Liu021115/WeatherStation/README.md

# WeatherStation

SDFN所在做的气象站

1.程序分为三个分支，分别为main，USB，OTA

2.每个文件夹内程序前缀：

RYK为老版本传感器，风速，风向等单独使用

XD为新版本传感器，七合一使用

3.程序后缀为开发板晶振（打板时有两种）

4.USB版本开发板上带有TYPC-C接口，移植文件系统可以从本地读取历史信息

OTA版本使用16MHz开发板，与USB版本相同，新增远程升级功能
