Liu021115/WeatherStation/执行流程图.jpg

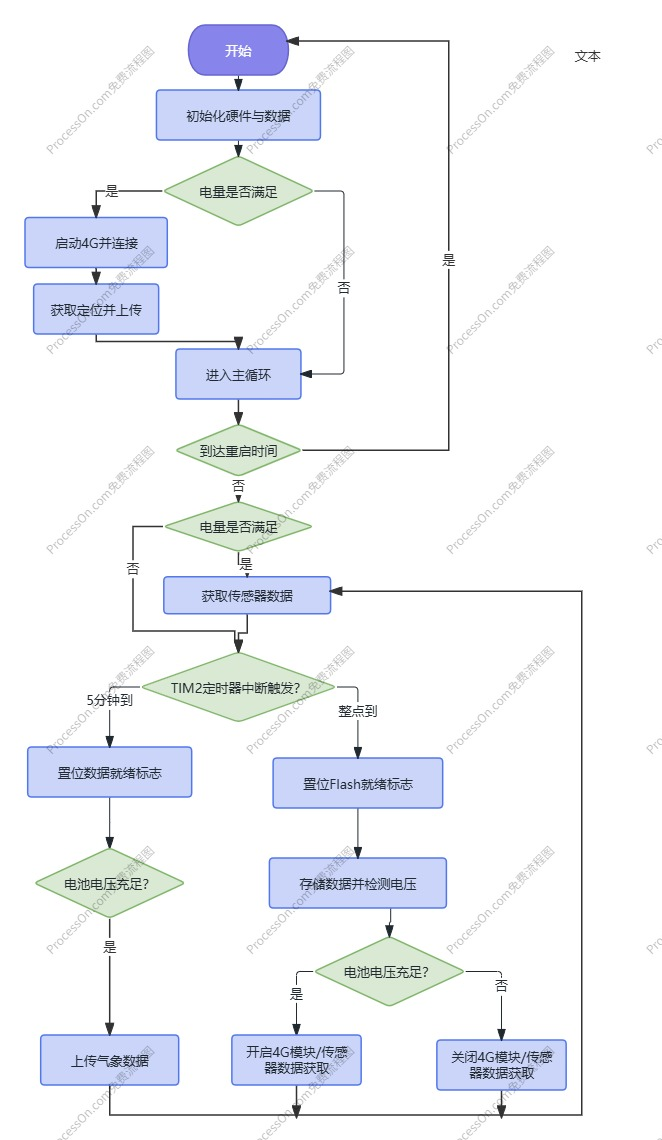
执行流程图.jpg
