Liu021115/WeatherStation/原理图.pdf

雨控
电源

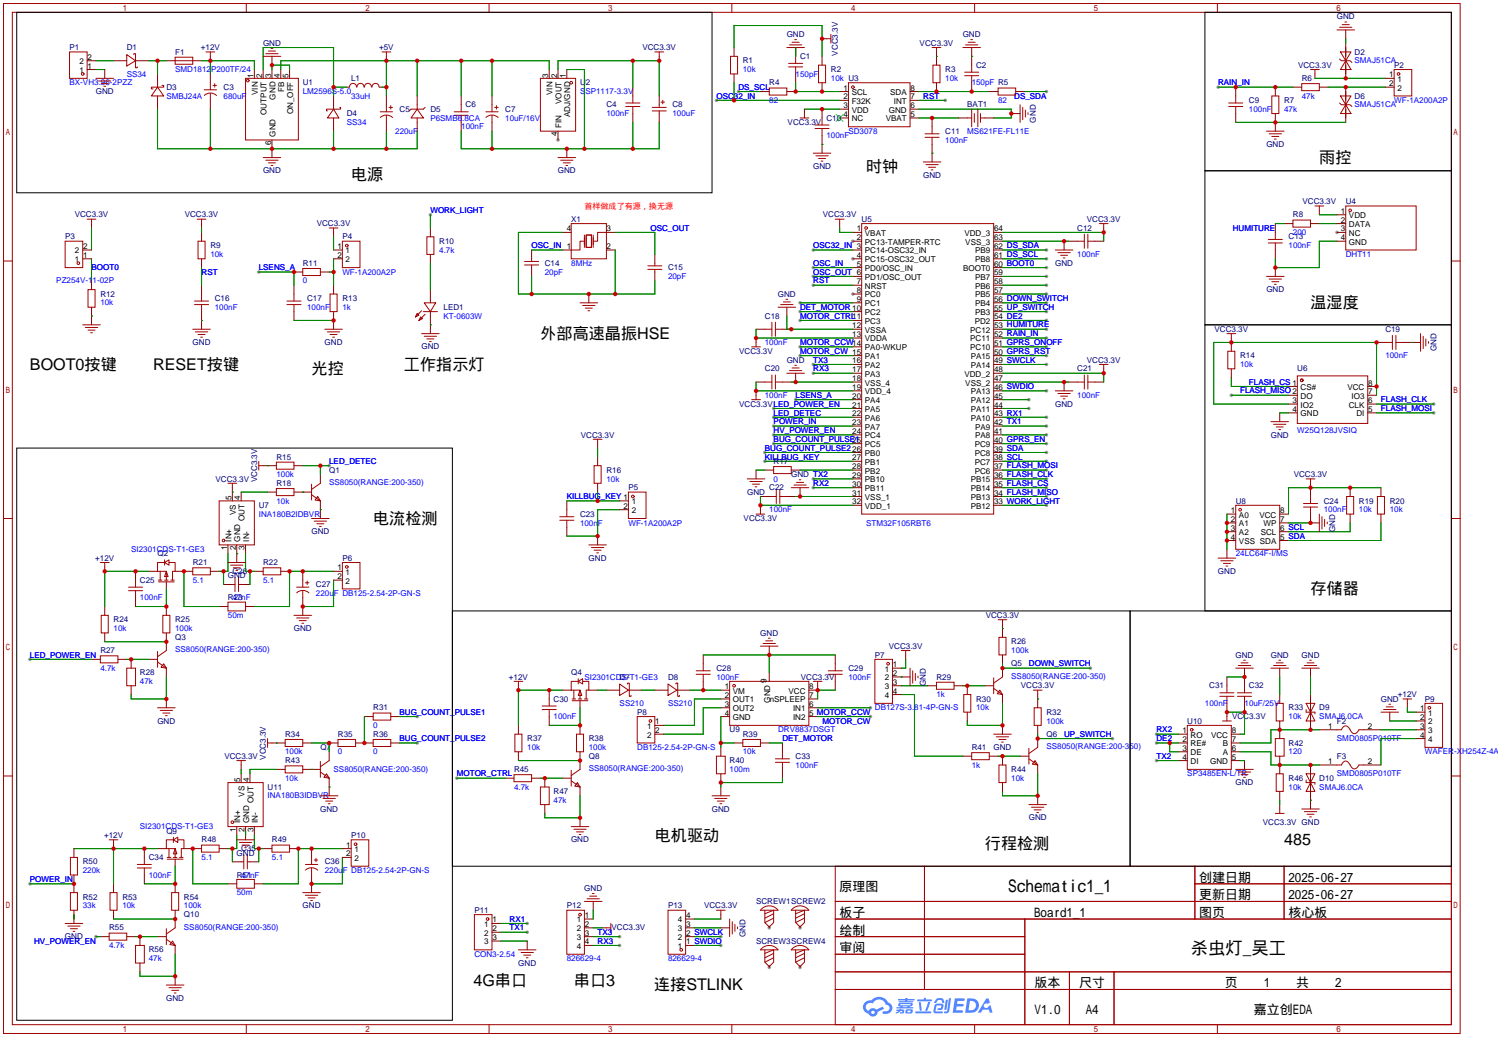
[picture p6: page 1]

原理图 | Schematic1_1 | 创建日期 | 2025-06-27

更新日期 | 2025-06-27

板子 | Board1_1 | 图页 | 核心板
绘制 | | 杀虫灯_吴工
审阅

V1.0 | A4 | 嘉立创EDA

# A76780C电源

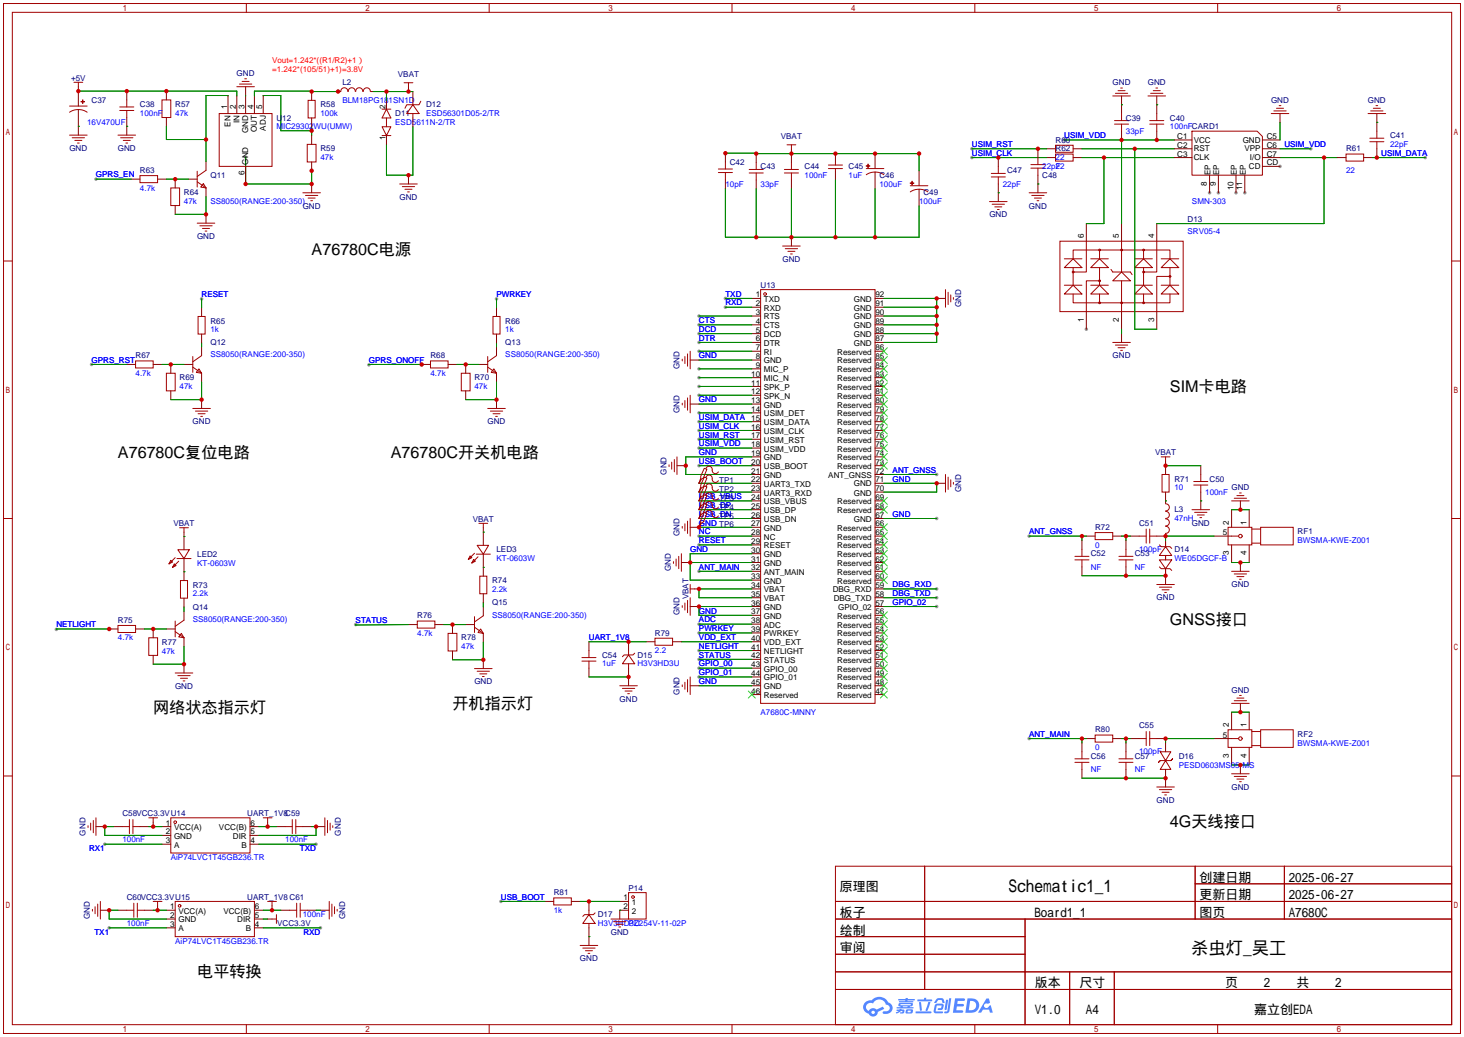
[picture p7: page 2]

原理图 | Schematic1_1 | 创建日期 | 2025-06-27

更新日期 | 2025-06-27

板子 | Board1_1 | 图页 | A7680C
绘制 | | 杀虫灯_吴工
审阅

V1.0 | A4 | 嘉立创EDA
