Liu021115/WeatherStation/RYK_16MHz/Hardware/W25Q128.c

#include "stm32f10x.h"                  // Device header
#include "MySPI.h"
#include "W25Q128_Ins.h"
#include "W25Q128.h"

/*****************************************************
W25Q128   128Mbit==16MB
分为256个块 		 每个块64KB
每个块16个扇区  每个扇区4KB
*****************************************************/

/**
  * 函    数：W25Q128初始化
  * 参    数：无
  * 返 回 值：无
  */
void W25Q128_Init(void)
{
	MySPI_Init();//先初始化底层的SPI
}

/**
  * 函    数：W25Q128读取ID号
  * 参    数：MID 工厂ID，使用输出参数的形式返回
  * 参    数：DID 设备ID，使用输出参数的形式返回
  * 返 回 值：无
  */
void W25Q128_ReadID(uint8_t *MID, uint16_t *DID)
{
	MySPI_Start();								//SPI起始
	MySPI_SwapByte(W25Q128_JEDEC_ID);			//交换发送读取ID的指令
	*MID = MySPI_SwapByte(W25Q128_DUMMY_BYTE);	//交换接收MID，通过输出参数返回
	*DID = MySPI_SwapByte(W25Q128_DUMMY_BYTE);	//交换接收DID高8位
	*DID <<= 8;									//高8位移到高位
	*DID |= MySPI_SwapByte(W25Q128_DUMMY_BYTE);	//或上交换接收DID的低8位，通过输出参数返回
	MySPI_Stop();								//SPI终止
}

/**
  * 函    数：W25Q128写使能
  * 参    数：无
  * 返 回 值：无
  */
void W25Q128_WriteEnable(void)
{
	MySPI_Start();								//SPI起始
	MySPI_SwapByte(W25Q128_WRITE_ENABLE);		//交换发送写使能的指令
	MySPI_Stop();								//SPI终止
}

/**
  * 函    数：W25Q128等待忙
  * 参    数：无
  * 返 回 值：无
  */
void W25Q128_WaitBusy(void)
{
	uint32_t Timeout;
	MySPI_Start();								//SPI起始
	MySPI_SwapByte(W25Q128_READ_STATUS_REGISTER_1);				//交换发送读状态寄存器1的指令
	Timeout = 100000;							//给定超时计数时间
	while ((MySPI_SwapByte(W25Q128_DUMMY_BYTE) & 0x01) == 0x01)	//循环等待忙标志位
	{
		Timeout --;								//等待时，计数值自减
		if (Timeout == 0)						//自减到0后，等待超时
		{
			/*超时的错误处理代码，可以添加到此处*/
			break;								//跳出等待，不等了
		}
	}
	MySPI_Stop();								//SPI终止
}

/**
  * 函    数：W25Q128页编程
  * 参    数：Address 页编程的起始地址，范围：0x000000~0xFFFFFF
  * 参    数：DataArray	用于写入数据的数组
  * 参    数：Count 要写入数据的数量，范围：0~256
  * 返 回 值：无
  * 注意事项：写入的地址范围不能跨页
  */
void W25Q128_PageProgram(uint32_t Address, uint8_t *DataArray, uint16_t Count)
{
	uint16_t i;
	
	W25Q128_WriteEnable();						//写使能
	
	MySPI_Start();								//SPI起始
	MySPI_SwapByte(W25Q128_PAGE_PROGRAM);		//交换发送页编程的指令
	MySPI_SwapByte(Address >> 16);				//交换发送地址23~16位
	MySPI_SwapByte(Address >> 8);				//交换发送地址15~8位
	MySPI_SwapByte(Address);					//交换发送地址7~0位
	for (i = 0; i < Count; i ++)				//循环Count次
	{
		MySPI_SwapByte(DataArray[i]);			//依次在起始地址后写入数据
	}
	MySPI_Stop();								//SPI终止
	
	W25Q128_WaitBusy();							//等待忙
}

/**
  * 函    数：W25Q128扇区擦除（4KB）
  * 参    数：Address 指定扇区的地址，范围：0x000000~0xFFFFFF 
* 每个扇区地址是xxx000_xxxFFF
  * 返 回 值：无
  */
void W25Q128_SectorErase(uint32_t Address)
{
	W25Q128_WriteEnable();						//写使能
	
	MySPI_Start();								//SPI起始
	MySPI_SwapByte(W25Q128_SECTOR_ERASE_4KB);	//交换发送扇区擦除的指令
	MySPI_SwapByte(Address >> 16);				//交换发送地址23~16位
	MySPI_SwapByte(Address >> 8);				//交换发送地址15~8位
	MySPI_SwapByte(Address);					//交换发送地址7~0位
	MySPI_Stop();								//SPI终止
	
	W25Q128_WaitBusy();							//等待忙
}

/**
  * 函    数：W25Q128芯片擦除
  * 参    数：擦除整个芯片
  * 返 回 值：无
  */
void W25Q128_ChipErase(void)
{
	W25Q128_WriteEnable();							//写使能	
	MySPI_Start();											//SPI起始
	MySPI_SwapByte(W25Q128_CHIP_ERASE);	//交换发送扇区擦除的指令
	MySPI_Stop();												//SPI终止
	W25Q128_WaitBusy();									//等待忙
}

/**
  * 函    数：W25Q128读取数据
  * 参    数：Address 读取数据的起始地址，范围：0x000000~0xFFFFFF
  * 参    数：DataArray 用于接收读取数据的数组，通过输出参数返回
  * 参    数：Count 要读取数据的数量，范围：0~0x1000000
  * 返 回 值：无
  */
void W25Q128_ReadData(uint32_t Address, uint8_t *DataArray, uint32_t Count)
{
	uint32_t i;
	MySPI_Start();													//SPI起始
	MySPI_SwapByte(W25Q128_READ_DATA);			//交换发送读取数据的指令
	MySPI_SwapByte(Address >> 16);					//交换发送地址23~16位
	MySPI_SwapByte(Address >> 8);						//交换发送地址15~8位
	MySPI_SwapByte(Address);								//交换发送地址7~0位
	for (i = 0; i < Count; i ++)						//循环Count次
		DataArray[i] = MySPI_SwapByte(W25Q128_DUMMY_BYTE);	//依次在起始地址后读取数据
	MySPI_Stop();														//SPI终止
}
