Liu021115/WeatherStation/RYK_16MHz/Hardware/rtc.h

#ifndef __RTC_H__
#define __RTC_H__

#include "stm32f10x.h"
#include "protocol_def.h"
#define  SCL_H         GPIOB->BSRR = GPIO_Pin_8 
#define  SCL_L         GPIOB->BRR  = GPIO_Pin_8 

#define  SDA_H         GPIOB->BSRR = GPIO_Pin_9
#define  SDA_L         GPIOB->BRR  = GPIO_Pin_9

#define SDA_read        (GPIOB->IDR  & GPIO_Pin_9)

enum Freq{F_0Hz, F32KHz, F4096Hz, F1024Hz, F64Hz, F32Hz, F16Hz, F8Hz, \
					F4Hz, F2Hz, F1Hz, F1_2Hz, F1_4Hz, F1_8Hz, F1_16Hz, F_1s};

enum clk_Souce{S_4096Hz, S_1024Hz, S_1s, S_1min};

/*此结构体定义了时间信息包括年、月、日、星期、时、分、秒*/
typedef	struct
{
	u8	second;
	u8	minute;
	u8	hour;
	u8	week;
	u8	day;
	u8	month;
	u8	year;
} Time_Def;

/*此结构体定义了倒计时中断可供配置的频率源、IM和初值主要参数*/
typedef	struct
{
	enum clk_Souce d_clk;
	u8   IM;	//IM=1:周期性中断
	u32  init_val;
} CountDown_Def;

/*
 * 通过宏定义选择使用的RTC型号
 * SD30XX_25XX -> 使用SD30或SD25系列
 * SD20XX_24XX -> 使用SD20或SD24系列
 */
#define		SD30XX_25XX
#undef		SD20XX_24XX

/********************************************************/
#define		TRUE            1
#define		FALSE           0
#define		H               1
#define		L               0
#define		Chg_enable			0x82
#define		Chg_disable			0

/******************** Device Address ********************/
#define		RTC_Address     0x64 

/******************** Alarm register ********************/
#define		Alarm_SC				0x07
#define		Alarm_MN				0x08
#define		Alarm_HR				0x09
#define		Alarm_WK				0x0A
#define		Alarm_DY				0x0B
#define		Alarm_MO				0x0C
#define		Alarm_YR				0x0D
#define		Alarm_EN				0x0E

/******************** Control Register *******************/
#define		CTR1            0x0F
#define		CTR2            0x10
#define		CTR3            0x11

/***************** Timer Counter Register ****************/
#define		Timer_Counter1	0x13
#define		Timer_Counter2	0x14
#define		Timer_Counter3	0x15

/******************** Battery Register ********************/
#define		Chg_MG          0x18		//充电管理寄存器地址
#define		Bat_H8          0x1A		//电量最高位寄存器地址
#define		Bat_L8          0x1B		//电量低八位寄存器地址

/*********************** ID Register **********************/
#define		ID_Address			0x72		//ID号起始地址

/********************** 报警中断宏定义 *********************/
#define		sec_ALM					0x01
#define		min_ALM					0x02
#define		hor_ALM					0x04
#define		wek_ALM					0x08
#define		day_ALM					0x10
#define		mon_ALM					0x20
#define		yar_ALM					0x40

/********************** 中断使能宏定义 **********************/
#define		INTDE						0x04		//倒计时中断
#define		INTAE						0x02		//报警中断
#define		INTFE						0x01		//频率中断

/********************** 中断演示宏定义 **********************/
#define 	FREQUENCY				0				//频率中断
#define 	ALARM						1				//报警中断
#define 	COUNTDOWN				2				//倒计时中断
#define 	DISABLEA					3				//禁止中断

/*************** 中断输出类型选择，请自行选择 ****************/
#define 	INT_TYPE			COUNTDOWN //定义中断输出类型

/***********读写时间函数*************/
u8 RTC_WriteDate(DateTime	*psRTC);
u8 RTC_ReadDate(DateTime	*psRTC);

/*******I2C多字节连续读写函数********/
u8 I2CWriteSerial(u8 DeviceAddress,u8 Address,u8 length,u8 *ps);
u8 I2CReadSerial(u8 DeviceAddress,u8 Address,u8 length,u8 *ps);

/*********I2C端口初始化函数*********/
void IIC_Init(void);

/*********RTC中断配置函数*********/
void Set_CountDown(CountDown_Def *CountDown_Init);
void Set_Alarm(u8 Enable_config, Time_Def *psRTC);
void SetFrq(enum Freq F_Out);
void ClrINT(u8 int_EN);

#endif /* __RTC_H */
