Liu021115/WeatherStation/RYK_16MHz/Hardware/LED.c

#include "stm32f10x.h"                  // Device header

/**
  * 函    数：LED初始化  电源指示灯
  * 参    数：无
  * 返 回 值：无
  */
void LED_Init(void)
{
	/*开启时钟*/
	RCC_APB2PeriphClockCmd(RCC_APB2Periph_GPIOB, ENABLE);		//开启GPIOB的时钟
	
	/*GPIO初始化*/
	GPIO_InitTypeDef GPIO_InitStructure;
	GPIO_InitStructure.GPIO_Mode = GPIO_Mode_Out_PP;
	GPIO_InitStructure.GPIO_Pin = GPIO_Pin_12;
	GPIO_InitStructure.GPIO_Speed = GPIO_Speed_50MHz;
	GPIO_Init(GPIOB, &GPIO_InitStructure);//将PB12引脚初始化为推挽输出
	
	/*设置GPIO初始化后的默认电平*/
	GPIO_SetBits(GPIOB, GPIO_Pin_12);				//设置PB12
}
