Liu021115/WeatherStation/RYK_16MHz/Hardware/LightRadiation.h

#ifndef __LIGHTRADIATION_H
#define __LIGHTRADIATION_H

#include "stm32f10x.h"
#include "RS485.h"
#include "string.h"
#include "stdio.h"

void Light_radiation_Printf(void);
void Light_radiation_Cmd(void);

#endif
