Liu021115/WeatherStation/RYK_16MHz/Hardware/WindDirection.h

#ifndef __WINDDIRECTION_H
#define __WINDDIRECTION_H

#include "stm32f10x.h"
#include "RS485.h"
#include "string.h"
#include "stdio.h"

void WindDirection_Cmd(void);
void WindDirection_Printf(void);

#endif
