Liu021115/WeatherStation/RYK_16MHz/Hardware/Power_test.c

#include "stm32f10x.h"                  // Device header
#include "Power_test.h"

StateOfBattrey StateOfHarfWare = ALL_OPEN;											// 外设开启状态
/**
  * 函    数：AD初始化
  * 参    数：无
  * 返 回 值：无
  */
void AD_Init(void)
{
	/*开启时钟*/
	RCC_APB2PeriphClockCmd(RCC_APB2Periph_ADC1, ENABLE);	//开启ADC1的时钟
	RCC_APB2PeriphClockCmd(RCC_APB2Periph_GPIOA, ENABLE);	//开启GPIOC的时钟
	
	/*设置ADC时钟*/
	RCC_ADCCLKConfig(RCC_PCLK2_Div2);						//选择时钟6分频，ADCCLK = 72MHz / 6 = 12MHz
	
	/*GPIO初始化*/
	GPIO_InitTypeDef GPIO_InitStructure;
	GPIO_InitStructure.GPIO_Mode = GPIO_Mode_AIN;
	GPIO_InitStructure.GPIO_Pin = GPIO_Pin_7;
	GPIO_InitStructure.GPIO_Speed = GPIO_Speed_50MHz;
	GPIO_Init(GPIOA, &GPIO_InitStructure);					//将PA7引脚初始化为模拟输入
	
	/*规则组通道配置*/
	ADC_RegularChannelConfig(ADC1, ADC_Channel_7, 1, ADC_SampleTime_55Cycles5);		//规则组序列1的位置，配置为通道7
	
	/*ADC初始化*/
	ADC_InitTypeDef ADC_InitStructure;						//定义结构体变量
	ADC_InitStructure.ADC_Mode = ADC_Mode_Independent;		//模式，选择独立模式，即单独使用ADC1
	ADC_InitStructure.ADC_DataAlign = ADC_DataAlign_Right;	//数据对齐，选择右对齐
	ADC_InitStructure.ADC_ExternalTrigConv = ADC_ExternalTrigConv_None;	//外部触发，使用软件触发，不需要外部触发
	ADC_InitStructure.ADC_ContinuousConvMode = DISABLE;		//连续转换，失能，每转换一次规则组序列后停止
	ADC_InitStructure.ADC_ScanConvMode = DISABLE;			//扫描模式，失能，只转换规则组的序列1这一个位置
	ADC_InitStructure.ADC_NbrOfChannel = 1;					//通道数，为1，仅在扫描模式下，才需要指定大于1的数，在非扫描模式下，只能是1
	ADC_Init(ADC1, &ADC_InitStructure);						//将结构体变量交给ADC_Init，配置ADC1
	
	/*ADC使能*/
	ADC_Cmd(ADC1, ENABLE);									//使能ADC1，ADC开始运行
	
	/*ADC校准*/
	ADC_ResetCalibration(ADC1);								//固定流程，内部有电路会自动执行校准
	while (ADC_GetResetCalibrationStatus(ADC1) == SET);
	ADC_StartCalibration(ADC1);
	while (ADC_GetCalibrationStatus(ADC1) == SET);
}

/**
  * 函    数：获取AD转换的值
  * 参    数：无
  * 返 回 值：AD转换的值，范围：0~4095
  */
uint16_t AD_GetValue(void)
{
	ADC_SoftwareStartConvCmd(ADC1, ENABLE);					//软件触发AD转换一次
	while (ADC_GetFlagStatus(ADC1, ADC_FLAG_EOC) == RESET);	//等待EOC标志位，即等待AD转换结束
	return ADC_GetConversionValue(ADC1);					//读数据寄存器，得到AD转换的结果
}


/**
  * 函    数：获取电压检测的值
  * 参    数：无
  * 返 回 值：电压计算值
  */
float PowerValue_GET(void)
{
	uint16_t ADvalue=AD_GetValue();
	//		float PowerValue=(float)ADvalue / 4095 * 3.3 / 33 * 253 ;
	float PowerValue=(float)ADvalue / 4095  / 10 * 253 ; //  ADC/4095*3.3 电压检测值     
	return PowerValue+0.4;															 //  二极管压降补偿
	
}

/**
  * 函    数：改变外设开启状态标志位
  * 参    数：
  * 返 回 值：无
  */
void HardWareFlagChange(float Battery_V)
{	
	if( Battery_V >= 10.5 )
		StateOfHarfWare = ALL_OPEN;
	else if( Battery_V >= 10 )
		StateOfHarfWare = CLOSE_4G;
	else
		StateOfHarfWare = CLOSE_ALL;
}
