Liu021115/WeatherStation/(commit log)

2026-03-24 提交基础版本
    标准版气象站程序
2026-03-24 说明文档
